diazmanuel/Antenna/Informe/Imagenes/D_Real_10GHz.png

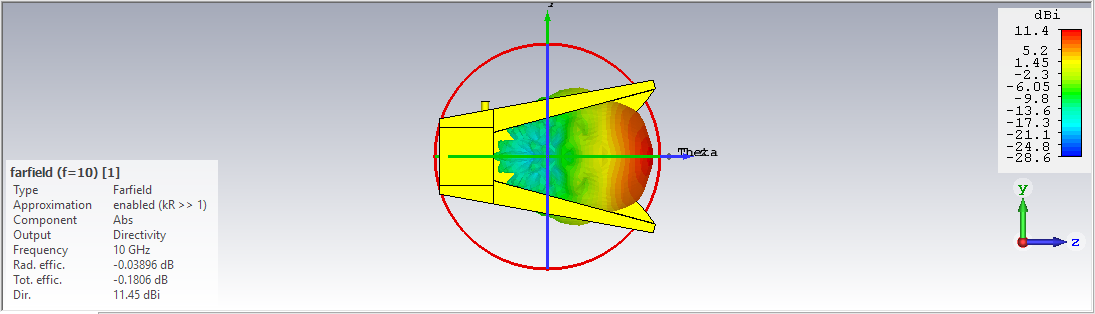
Informe/Imagenes/D_Real_10GHz.png
