diazmanuel/Antenna/Informe/Imagenes/Enlace_VNA1.png

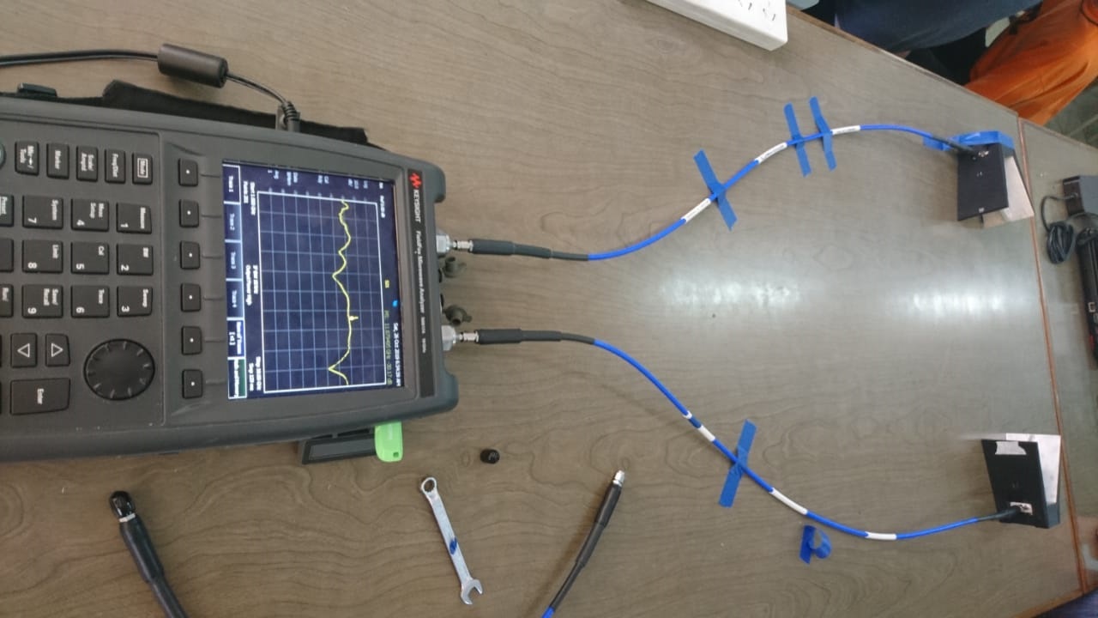
Informe/Imagenes/Enlace_VNA1.png
