diazmanuel/Antenna/README.md

# Antenna
Antenna Double Ridge Impresora 3D
