diazmanuel/Antenna/Informe/Imagenes/D_Teorico_10GHz.png

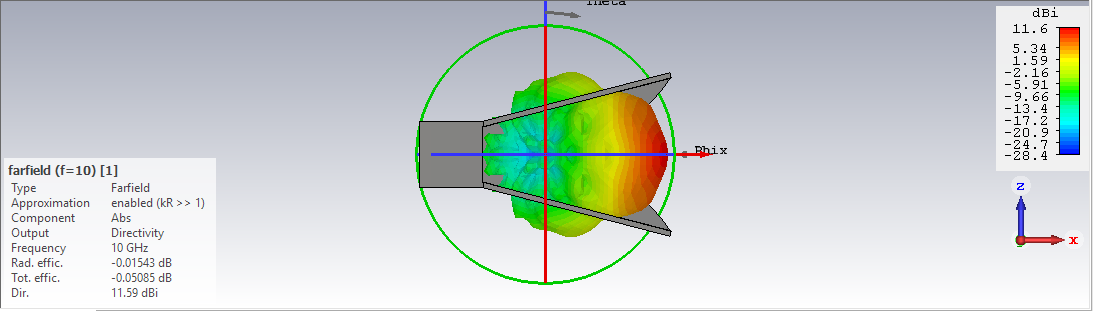
Informe/Imagenes/D_Teorico_10GHz.png
