diazmanuel/Antenna/Informe/Imagenes/Enlace_VNA2.png

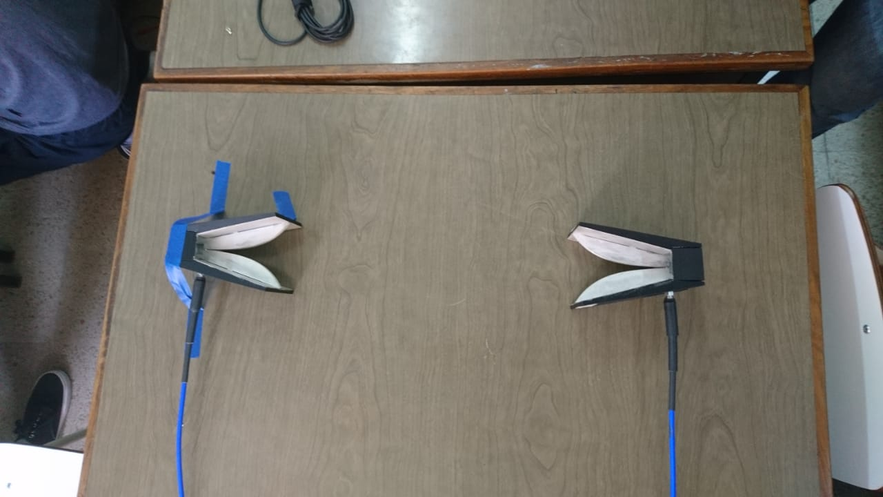
Informe/Imagenes/Enlace_VNA2.png
