diazmanuel/Antenna/Informe/Imagenes/ROE_Medicion.png

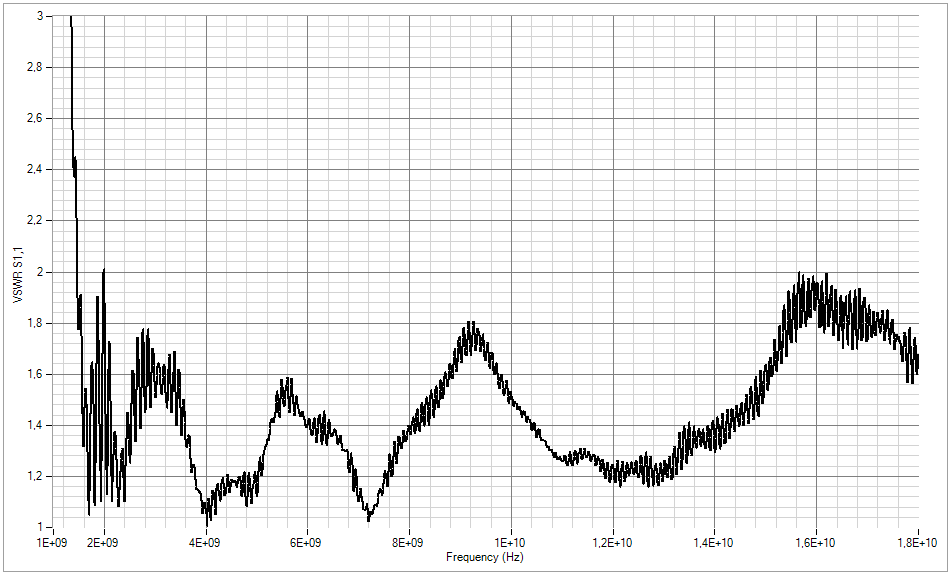
Informe/Imagenes/ROE_Medicion.png
