diazmanuel/Antenna/Informe/Imagenes/Var1.png

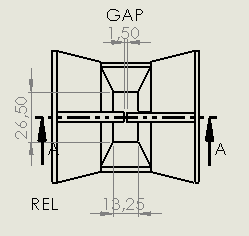
Informe/Imagenes/Var1.png
