diazmanuel/Antenna/Informe/Imagenes/Var2.png

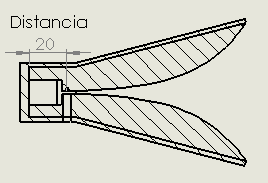
Informe/Imagenes/Var2.png
