diazmanuel/Antenna/Simulaciones/Diseño Real/ANTENNA/Model/3D/ANTENNA_1.bmp

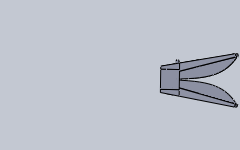
Simulaciones/Diseño Real/ANTENNA/Model/3D/ANTENNA_1.bmp
