diazmanuel/Antenna/Simulaciones/Diseño Teorico/ANTENNA/Model/3D/ANTENA_V1_1.bmp

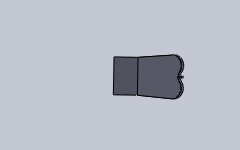
Simulaciones/Diseño Teorico/ANTENNA/Model/3D/ANTENA_V1_1.bmp
