diazmanuel/Antenna/Simulaciones/Diseño Teorico/ANTENNA/Model/3D/ANTENA_V1_4.bmp

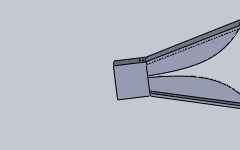
Simulaciones/Diseño Teorico/ANTENNA/Model/3D/ANTENA_V1_4.bmp
