diazmanuel/Antenna/Diseño 3D/Diseño Teorico/Piezas/ANTENA+SONDA.SLDASM

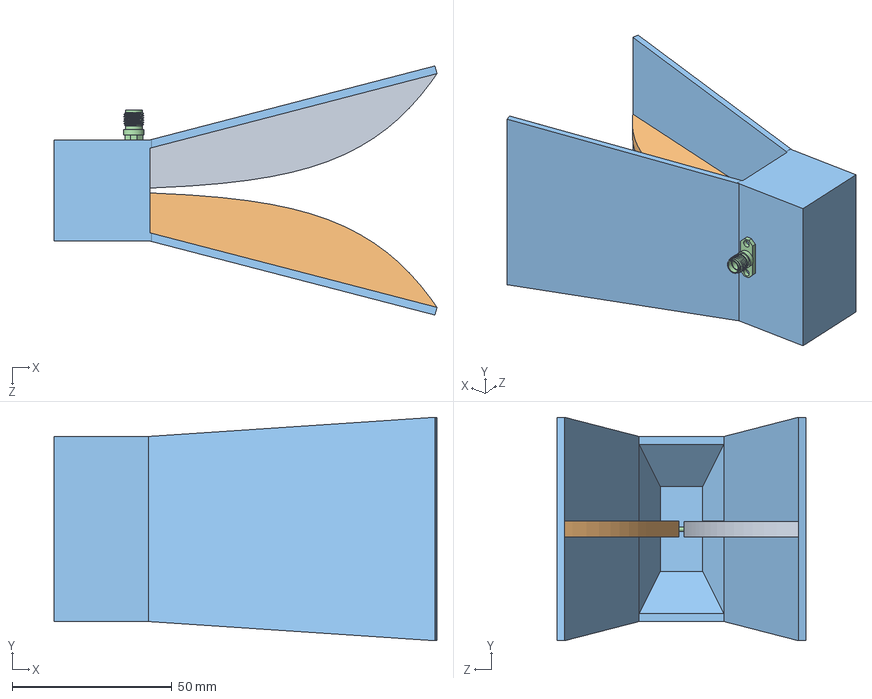
[picture p32: CAD file, 2019-12-15]
Diseño 3D/Diseño Teorico/Piezas/ANTENA+SONDA.SLDASM
120.0 x 70.0 x 78.1 mm
Pieza1
Pieza2
Pieza3
901-9891-rfx
