diazmanuel/Antenna/Diseño 3D/Diseño Real/Piezas/ANTENNA+sonda.SLDASM

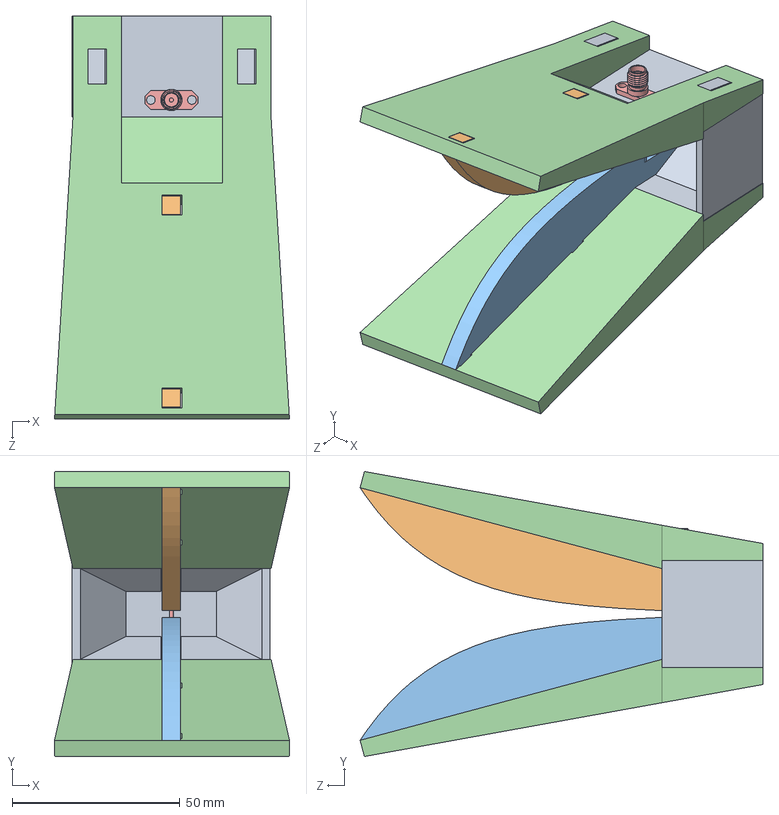
[picture p33: CAD file, 2019-12-08]
Diseño 3D/Diseño Real/Piezas/ANTENNA+sonda.SLDASM
70.0 x 84.9 x 120.0 mm
CAJA
JOROBA-1
JOROBA-2
ALETA x 2
901-9891-rfx
