diazmanuel/Antenna/Diseño 3D/Diseño Teorico/Piezas/ANTENA-SOLA.SLDASM

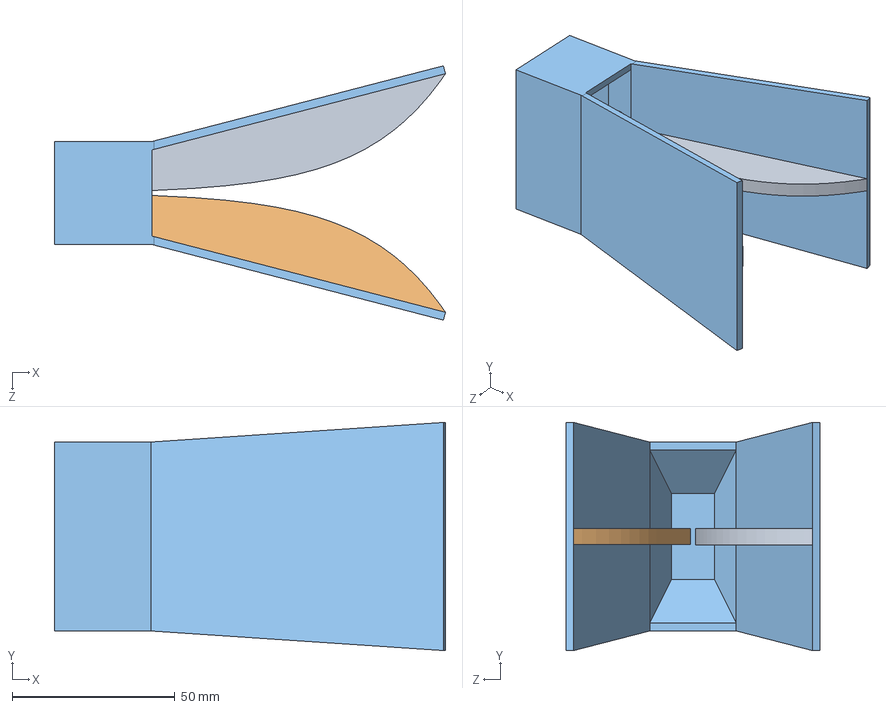
[picture p34: CAD file, 2019-12-08]
Diseño 3D/Diseño Teorico/Piezas/ANTENA-SOLA.SLDASM
120.0 x 70.0 x 78.1 mm
Pieza1
Pieza2
Pieza3
