diazmanuel/Antenna/Diseño 3D/Diseño Real/Piezas/ANTENNA.SLDASM

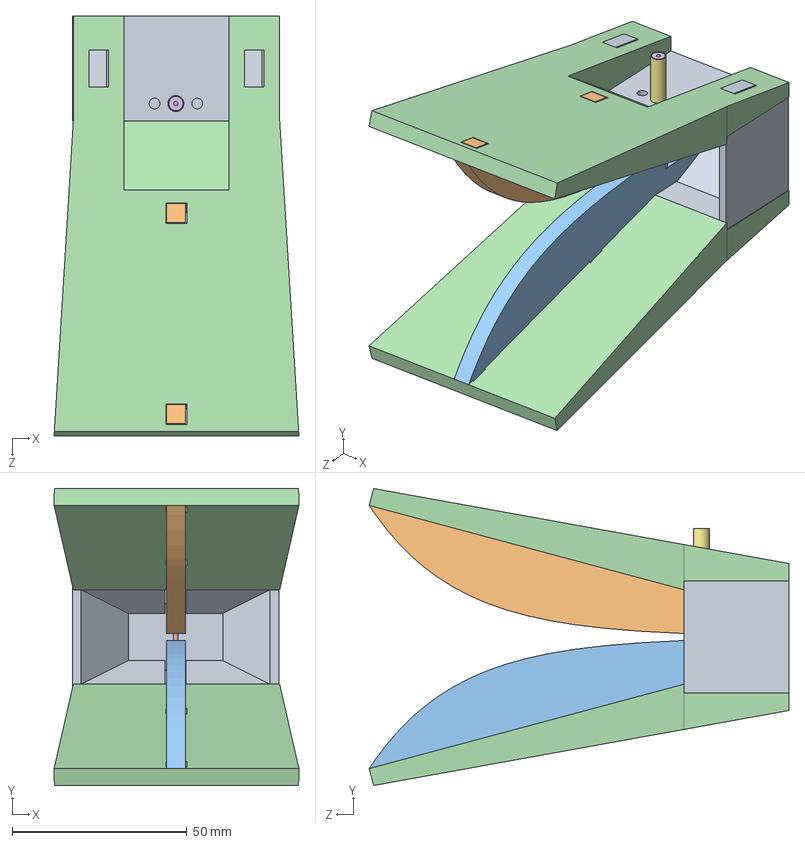
[picture p35: CAD file, 2019-12-08]
Diseño 3D/Diseño Real/Piezas/ANTENNA.SLDASM
70.0 x 84.9 x 120.0 mm
CAJA
JOROBA-1
JOROBA-2
ALETA x 2
Pieza4
Pieza5
Pieza6
