diazmanuel/Antenna/Diseño 3D/Diseño Real/Archivos Impresora 3D/ALETAx2.STL

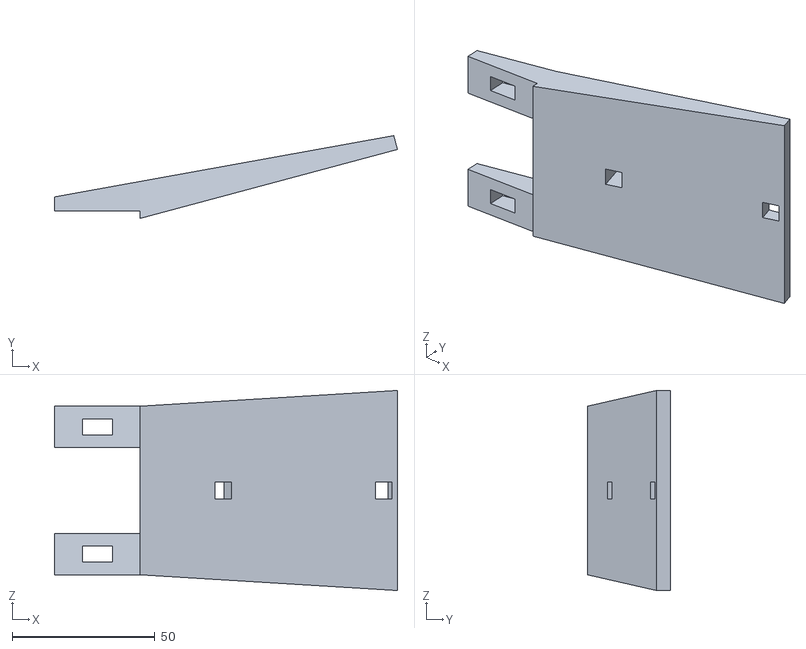
[picture p36: CAD file, 2019-12-08]
Diseño 3D/Diseño Real/Archivos Impresora 3D/ALETAx2.STL
120.0 x 28.9 x 70.0
