diazmanuel/Antenna/Diseño 3D/Diseño Real/Piezas/JOROBA-2.SLDPRT

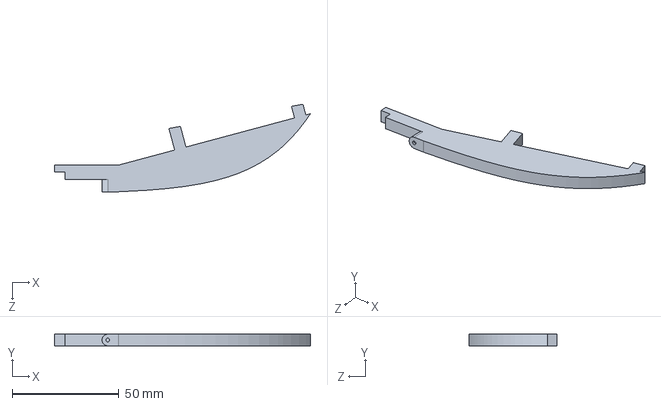
[picture p37: CAD file, 2019-12-08]
Diseño 3D/Diseño Real/Piezas/JOROBA-2.SLDPRT
120.0 x 5.50 x 41.0 mm
