diazmanuel/Antenna/Diseño 3D/Diseño Real/Archivos Impresora 3D/JOROBA-1x1.STL

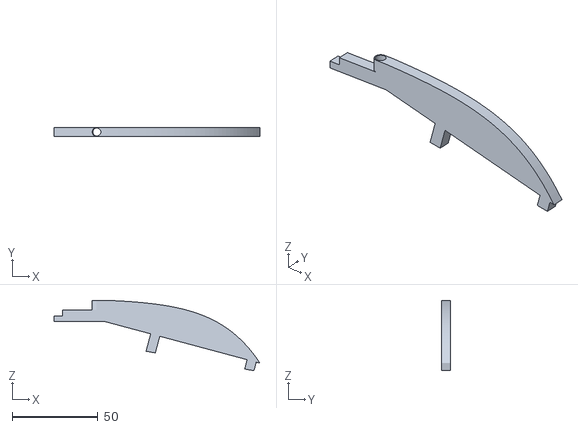
[picture p38: CAD file, 2019-12-08]
Diseño 3D/Diseño Real/Archivos Impresora 3D/JOROBA-1x1.STL
120.0 x 5.50 x 41.0
