diazmanuel/Antenna/Diseño 3D/Diseño Real/Piezas/Pieza6.SLDPRT

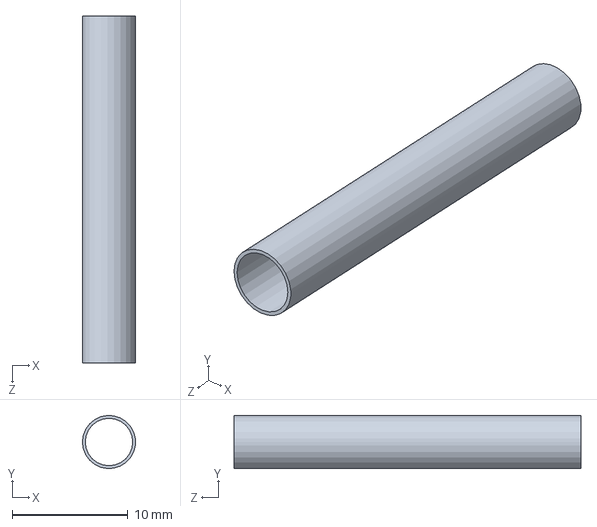
[picture p39: CAD file, 2019-12-08]
Diseño 3D/Diseño Real/Piezas/Pieza6.SLDPRT
4.60 x 4.59 x 30.0 mm
