diazmanuel/Antenna/Diseño 3D/Diseño Teorico/Piezas/Pieza6.SLDPRT

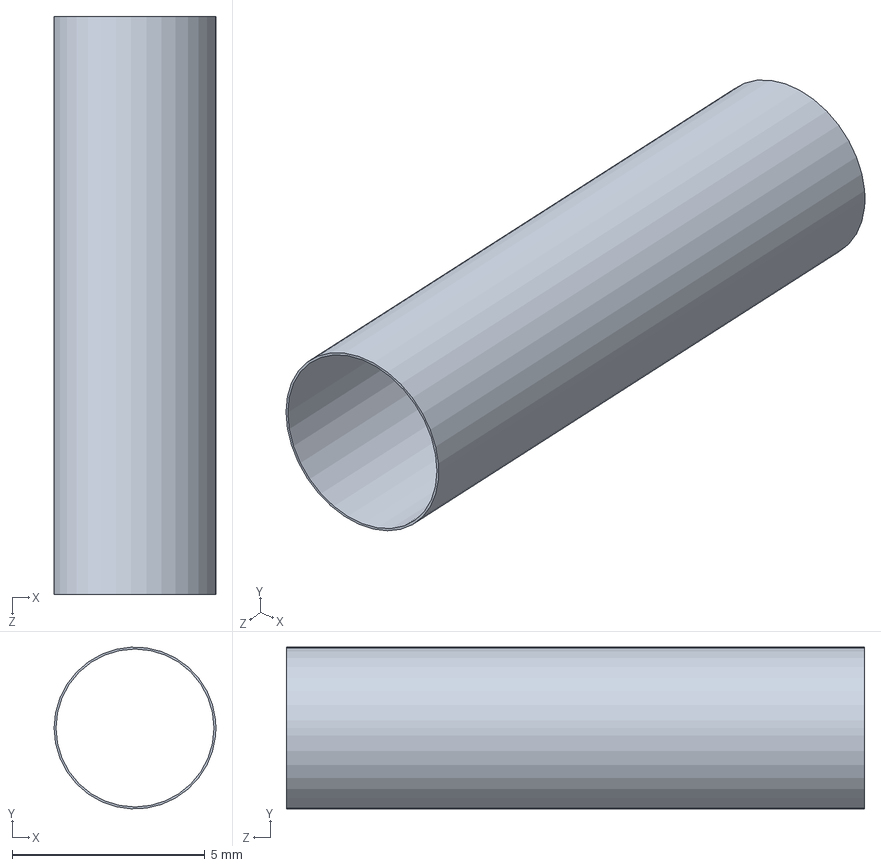
[picture p40: CAD file, 2019-12-08]
Diseño 3D/Diseño Teorico/Piezas/Pieza6.SLDPRT
4.20 x 4.20 x 15.0 mm
