diazmanuel/Antenna/Diseño 3D/Diseño Real/Archivos Impresora 3D/CAJAx1.STL

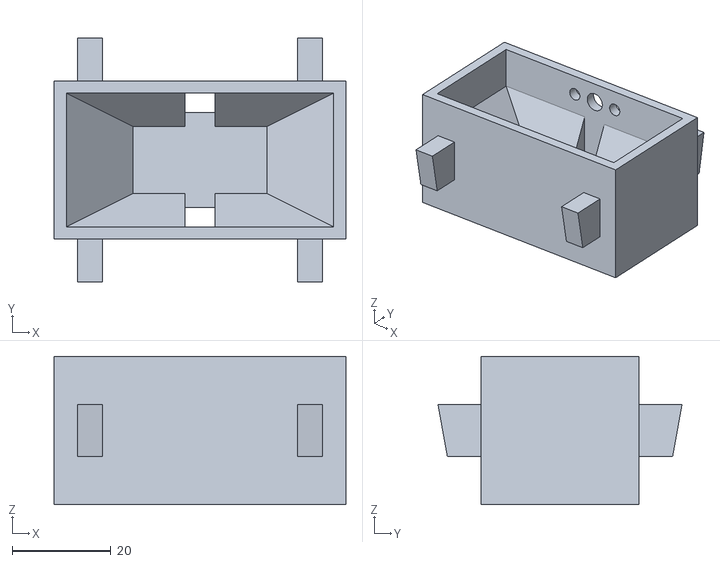
[picture p41: CAD file, 2019-12-08]
Diseño 3D/Diseño Real/Archivos Impresora 3D/CAJAx1.STL
59.0 x 49.3 x 30.0
