diazmanuel/Antenna/Diseño 3D/Diseño Teorico/Piezas/Pieza2.SLDPRT

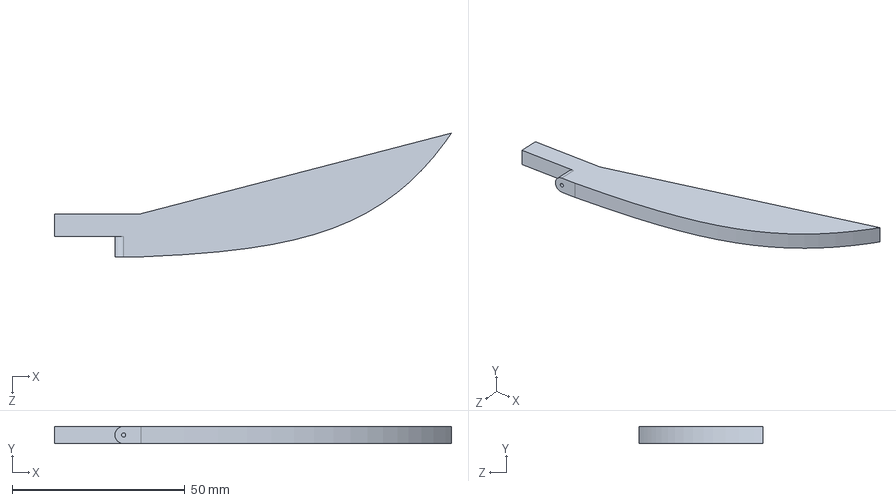
[picture p42: CAD file, 2019-12-08]
Diseño 3D/Diseño Teorico/Piezas/Pieza2.SLDPRT
115.0 x 5.00 x 35.9 mm
