diazmanuel/Antenna/Diseño 3D/Diseño Teorico/Piezas/Pieza4.SLDPRT

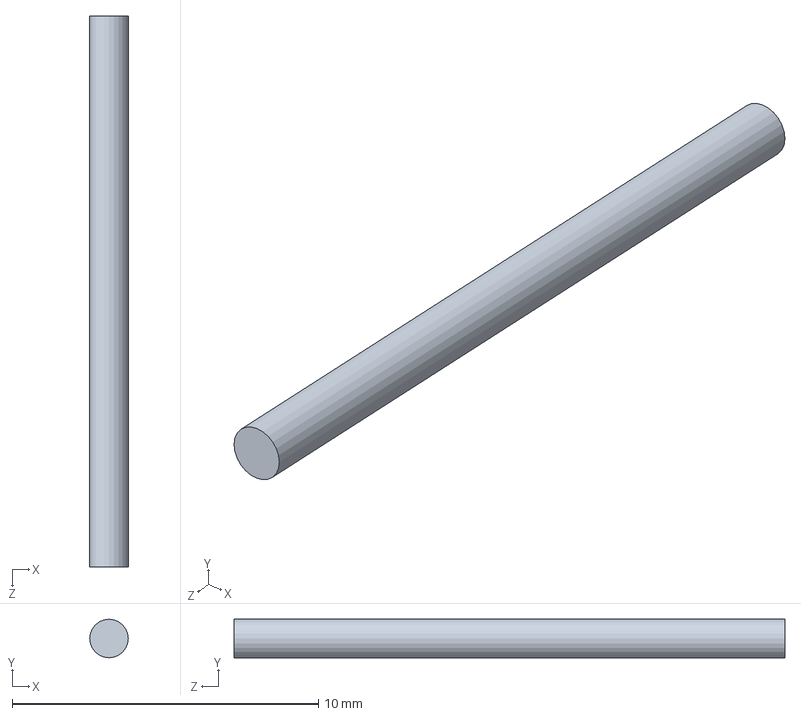
[picture p43: CAD file, 2019-12-08]
Diseño 3D/Diseño Teorico/Piezas/Pieza4.SLDPRT
1.26 x 1.26 x 18.0 mm
