diazmanuel/Antenna/Diseño 3D/Diseño Teorico/Piezas/Pieza5.SLDPRT

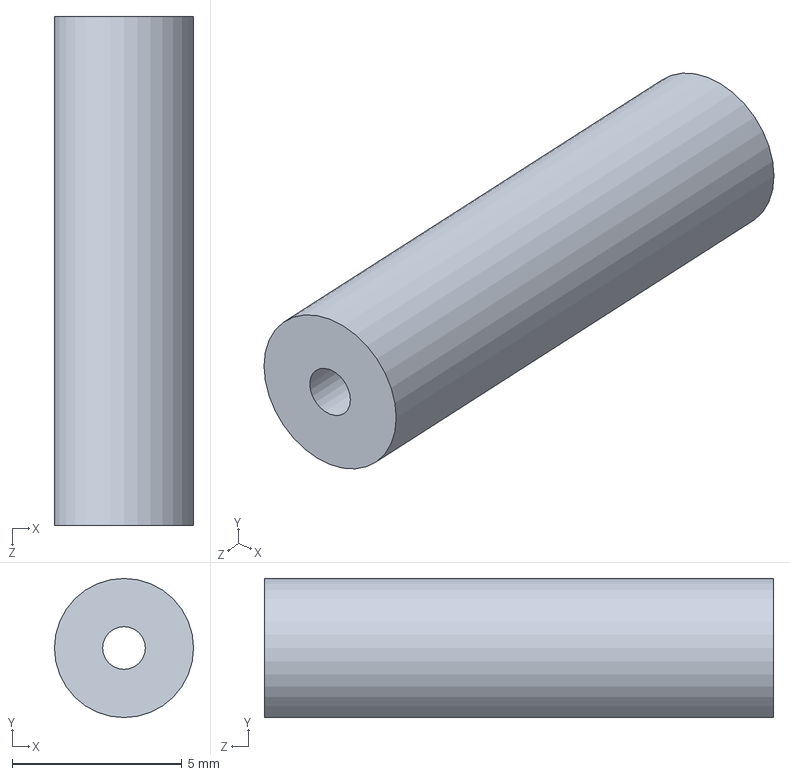
[picture p44: CAD file, 2019-12-08]
Diseño 3D/Diseño Teorico/Piezas/Pieza5.SLDPRT
4.10 x 4.10 x 15.0 mm
