diazmanuel/Antenna/Diseño 3D/Diseño Real/Piezas/Pieza5.SLDPRT

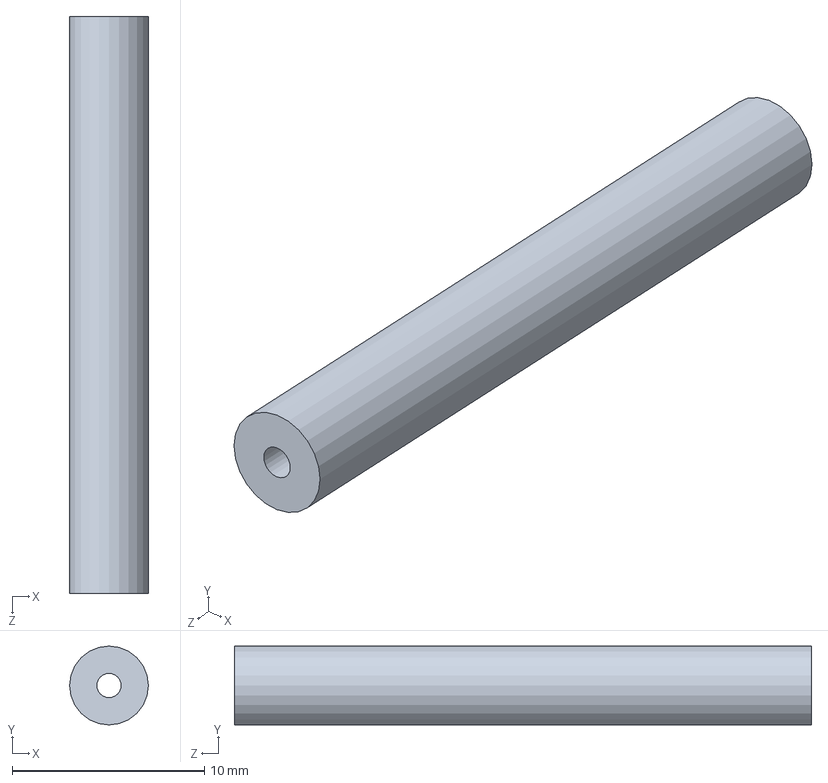
[picture p45: CAD file, 2019-12-08]
Diseño 3D/Diseño Real/Piezas/Pieza5.SLDPRT
4.10 x 4.10 x 30.0 mm
