diazmanuel/Antenna/Diseño 3D/Diseño Teorico/Piezas/Pieza3.SLDPRT

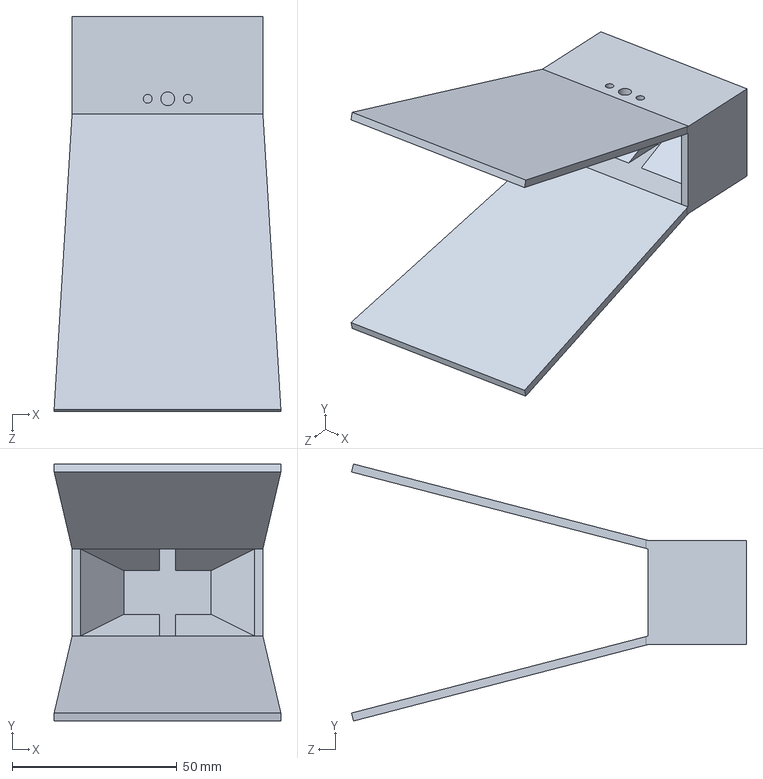
[picture p46: CAD file, 2019-12-08]
Diseño 3D/Diseño Teorico/Piezas/Pieza3.SLDPRT
68.9 x 78.1 x 120.0 mm
