diazmanuel/Antenna/Diseño 3D/Diseño Real/Piezas/901-9891-rfx.SLDPRT

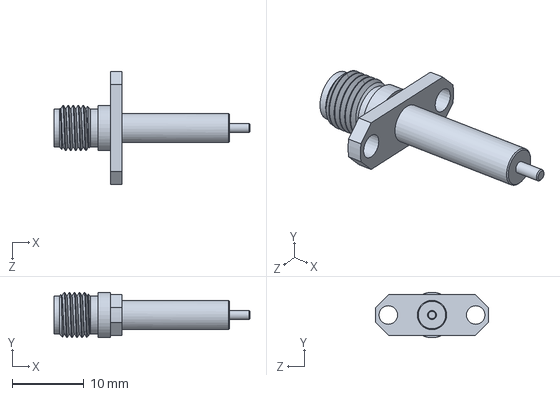
[picture p47: CAD file, 2019-12-08]
Diseño 3D/Diseño Real/Piezas/901-9891-rfx.SLDPRT
27.4 x 6.35 x 15.9 mm
