diazmanuel/Antenna/Diseño 3D/Diseño Teorico/Piezas/Pieza1.SLDPRT

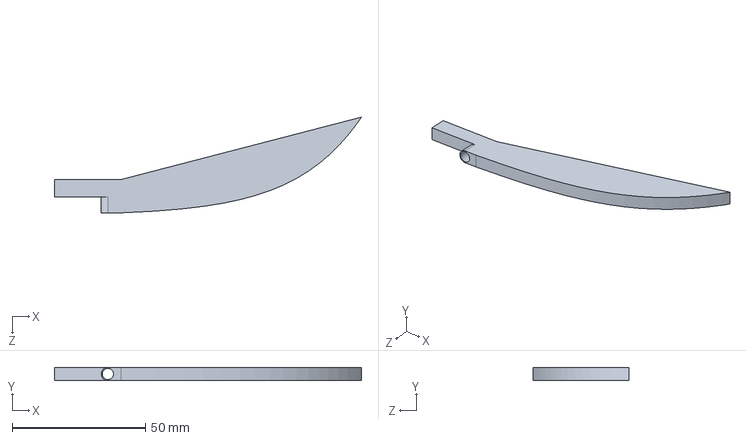
[picture p48: CAD file, 2019-12-08]
Diseño 3D/Diseño Teorico/Piezas/Pieza1.SLDPRT
115.0 x 5.00 x 35.9 mm
