diazmanuel/Antenna/Diseño 3D/Diseño Real/Piezas/Pieza4.SLDPRT

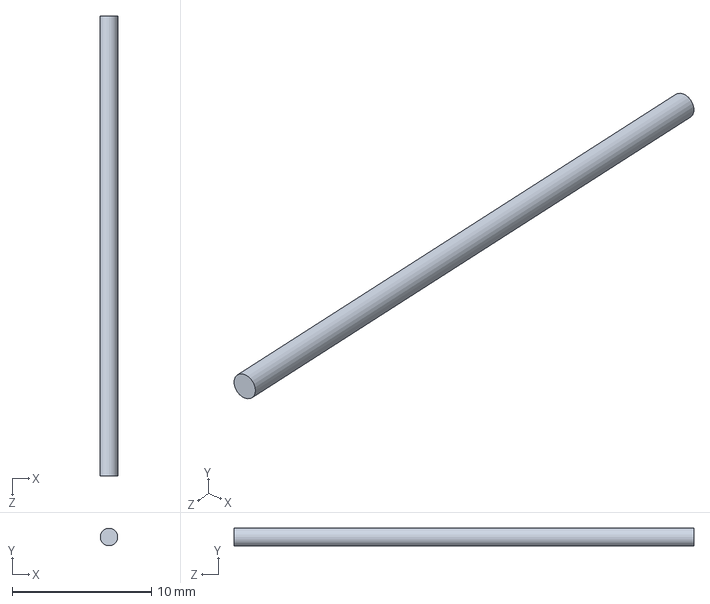
[picture p49: CAD file, 2019-12-08]
Diseño 3D/Diseño Real/Piezas/Pieza4.SLDPRT
1.26 x 1.26 x 33.0 mm
