diazmanuel/Antenna/(list of files, cad)

Other CAD files:
Diseño 3D/Diseño Teorico/Piezas/ANTENA_V1.SLDASM
Diseño 3D/Diseño Real/Archivos Impresora 3D/JOROBA-2x1.STL
Diseño 3D/Diseño Real/Piezas/CAJA.SLDPRT
Diseño 3D/Diseño Real/Piezas/JOROBA-1.SLDPRT
Diseño 3D/Diseño Real/Piezas/ALETA.SLDPRT
Diseño 3D/Diseño Real/Piezas/ANTENNA+sonda.STL
Diseño 3D/Diseño Real/Planos/ALETA.SLDDRW
Diseño 3D/Diseño Real/Planos/ANTENNA.SLDDRW
Diseño 3D/Diseño Real/Planos/CAJA.SLDDRW
Diseño 3D/Diseño Real/Planos/JOROBA-1.SLDDRW
Diseño 3D/Diseño Real/Planos/JOROBA-2.SLDDRW
Diseño 3D/Diseño Teorico/Planos/ANTENNA.SLDDRW
Diseño 3D/Diseño Teorico/Planos/Pieza1.SLDDRW
Diseño 3D/Diseño Teorico/Planos/Pieza2.SLDDRW
Diseño 3D/Diseño Teorico/Planos/Pieza3.SLDDRW
Simulaciones/Diseño Real/ANTENNA/ModelCache/Model.psm
Simulaciones/Diseño Real/ANTENNA/Result/Port1_e1.prt
Simulaciones/Diseño Real/ANTENNA/Result/Port1_e1[9.5].prt
Simulaciones/Diseño Real/ANTENNA/Result/Port1_h1.prt
Simulaciones/Diseño Real/ANTENNA/Result/Port1_h1[9.5].prt
Simulaciones/Diseño Real/ANTENNA/Result/adapt_Port1_e1.prt
Simulaciones/Diseño Real/ANTENNA/Result/adapt_Port1_e1[9.5].prt
Simulaciones/Diseño Real/ANTENNA/Result/adapt_Port1_h1.prt
Simulaciones/Diseño Real/ANTENNA/Result/adapt_Port1_h1[9.5].prt
Simulaciones/Diseño Teorico/ANTENNA/ModelCache/Model.psm
Simulaciones/Diseño Teorico/ANTENNA/Result/Port1_e1.prt
Simulaciones/Diseño Teorico/ANTENNA/Result/Port1_e1[9.5].prt
Simulaciones/Diseño Teorico/ANTENNA/Result/Port1_h1.prt
Simulaciones/Diseño Teorico/ANTENNA/Result/Port1_h1[9.5].prt
Simulaciones/Diseño Teorico/ANTENNA/Result/adapt_Port1_e1.prt
Simulaciones/Diseño Teorico/ANTENNA/Result/adapt_Port1_e1[9.5].prt
Simulaciones/Diseño Teorico/ANTENNA/Result/adapt_Port1_h1.prt
Simulaciones/Diseño Teorico/ANTENNA/Result/adapt_Port1_h1[9.5].prt
