diazmanuel/Antenna/Resultados/SETUP.txt

power level -15dbm
resolution 1601 puntos
BW filter 1khz
kit de calibracion:	85518A KITSIGHT OSM
freq: 1Ghz - 18Ghz
