diazmanuel/Antenna/Simulaciones/Diseño Real/ANTENNA/Result/FarfieldBkGround.bmp

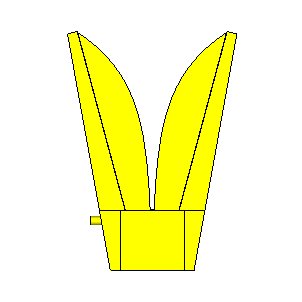
Simulaciones/Diseño Real/ANTENNA/Result/FarfieldBkGround.bmp
