diazmanuel/Antenna/Simulaciones/Diseño Teorico/ANTENNA/Result/FarfieldBkGround.bmp

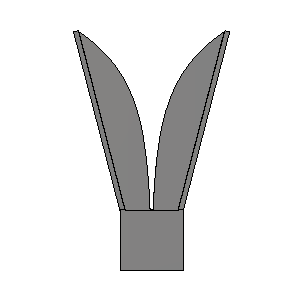
Simulaciones/Diseño Teorico/ANTENNA/Result/FarfieldBkGround.bmp
