diazmanuel/Antenna/Diseño 3D/Diseño Real/Planos/ALETA.PDF

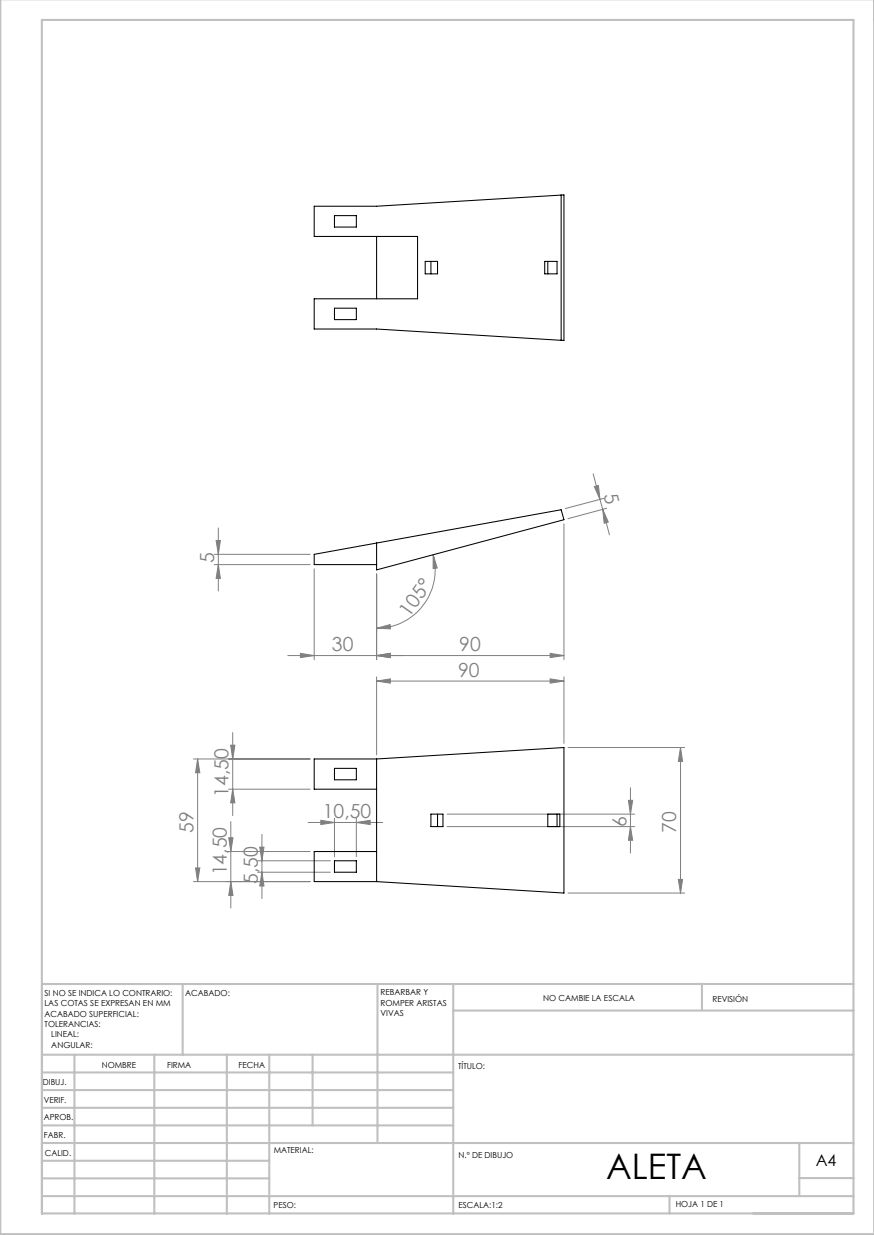
[picture p52: page 1]
ESCALA:1:2; HOJA 1 DE 1; NO CAMBIE LA ESCALA; REVISIÓN; REBARBAR Y ROMPER ARISTAS; SI NO SE INDICA LO CONTRARIO:; ACABADO:

LAS COTAS SE EXPRESAN EN MM
ACABADO SUPERFICIAL:
TOLERANCIAS:
LINEAL:
ANGULAR:

NOMBRE | FIRMA | FECHA | | | | TÍTULO:
CALID. | | | | MATERIAL: | ALETA PESO: N.º DE DIBUJO | A4

DIBUJ.
VERIF.
APROB.
FABR.
