diazmanuel/Antenna/Diseño 3D/Diseño Real/Planos/CAJA.PDF

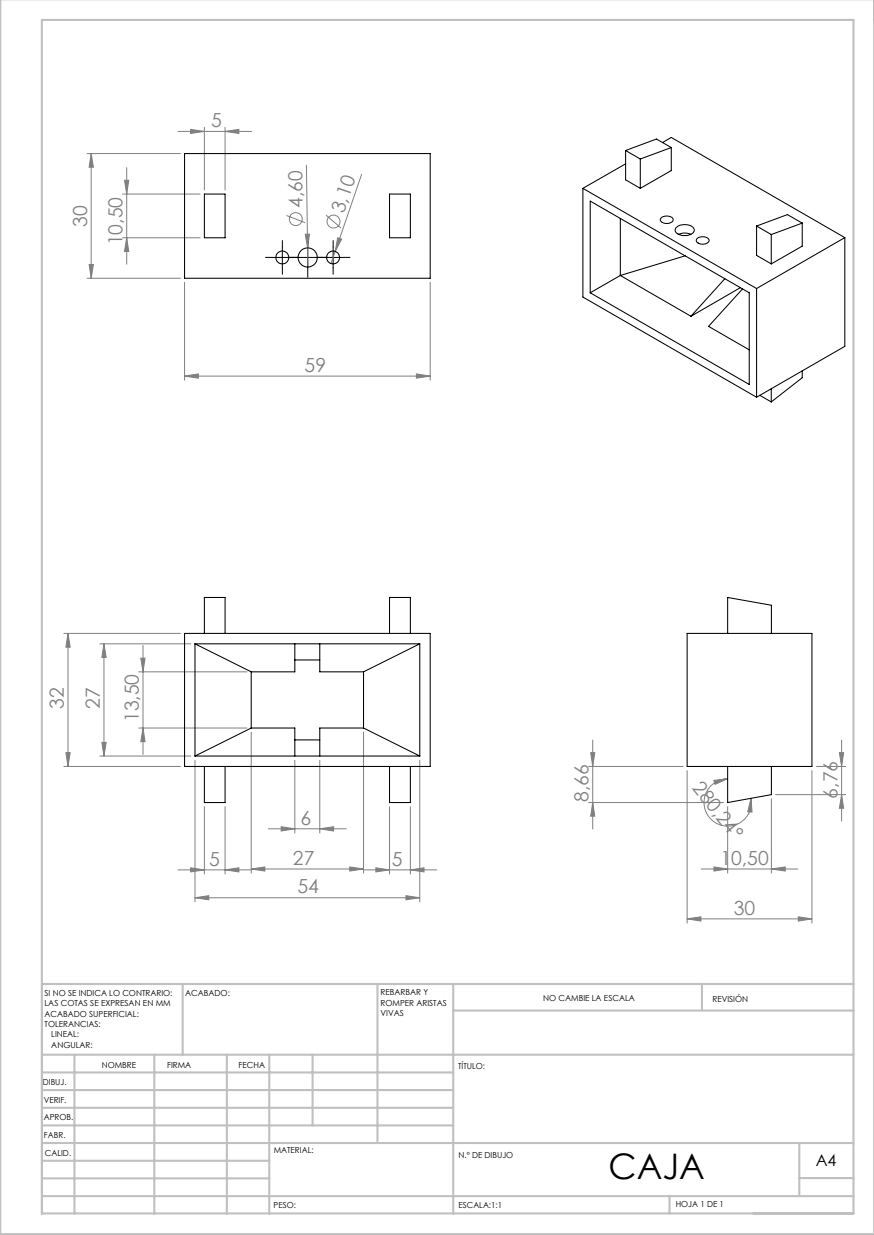
[picture p53: page 1]
ESCALA:1:1; HOJA 1 DE 1; NO CAMBIE LA ESCALA; REVISIÓN; REBARBAR Y ROMPER ARISTAS; SI NO SE INDICA LO CONTRARIO:; ACABADO:

LAS COTAS SE EXPRESAN EN MM
ACABADO SUPERFICIAL:
TOLERANCIAS:
LINEAL:
ANGULAR:

NOMBRE | FIRMA | FECHA | | | | TÍTULO:

DIBUJ.
VERIF.
APROB.
FABR.
CALID. | | | | MATERIAL: | CAJA PESO: N.º DE DIBUJO | A4
