diazmanuel/Antenna/(list of files, drawings)

Other design files:
Simulaciones/Diseño Real/ANTENNA/Model/3D/Model.dsn
Simulaciones/Diseño Teorico/ANTENNA/Model/3D/Model.dsn
