diazmanuel/Antenna/(commit log)

2019-12-08 Antenna design
    diseño
    [901-9891-rfx.SLDPRT, ALETA.SLDDRW, ALETA.SLDPRT, ALETAx2.STL, ANTENA+SONDA.SLDASM, ANTENA-SOLA.SLDASM, ANTENA_V1.SLDASM, ANTENNA+sonda.SLDASM]
2019-12-08 simulaciones + resultados
    [Model.dsn, Model.psm, Port1_e1.prt, Port1_e1[9.5].prt, Port1_h1.prt, Port1_h1[9.5].prt, adapt_Port1_e1.prt, adapt_Port1_e1[9.5].prt]
2019-12-10 Correcciones de informe
